auomoto/BOSS-LN2-Controller/README.md

# BOSS-LN2-Controller
## Liquid Nitrogen Fill Controller for the LCO BOSS Spectrograph
This separate unit automatically fills the small CCD dewars on the BOSS Spectrographs from a larger buffer dewar installed on the telescope rotator. That buffer dewar is filled twice a day (dusk, dawn).
