auomoto/BOSS-LN2-Controller/Hardware/Eagle/Thermistor Hysteresis Example.png

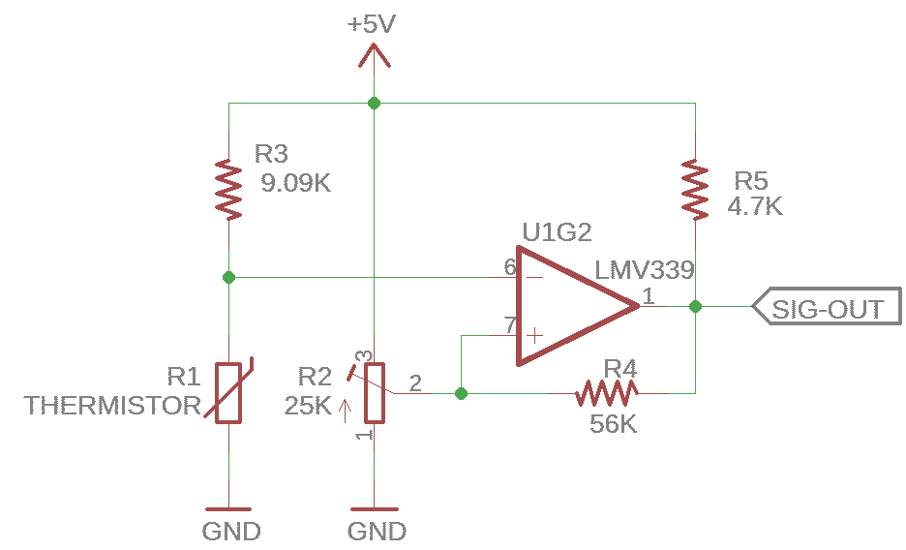
Hardware/Eagle/Thermistor Hysteresis Example.png
