auomoto/BOSS-LN2-Controller/Hardware/Eagle/2021-06-29 LN2 Autofill Controller.pdf

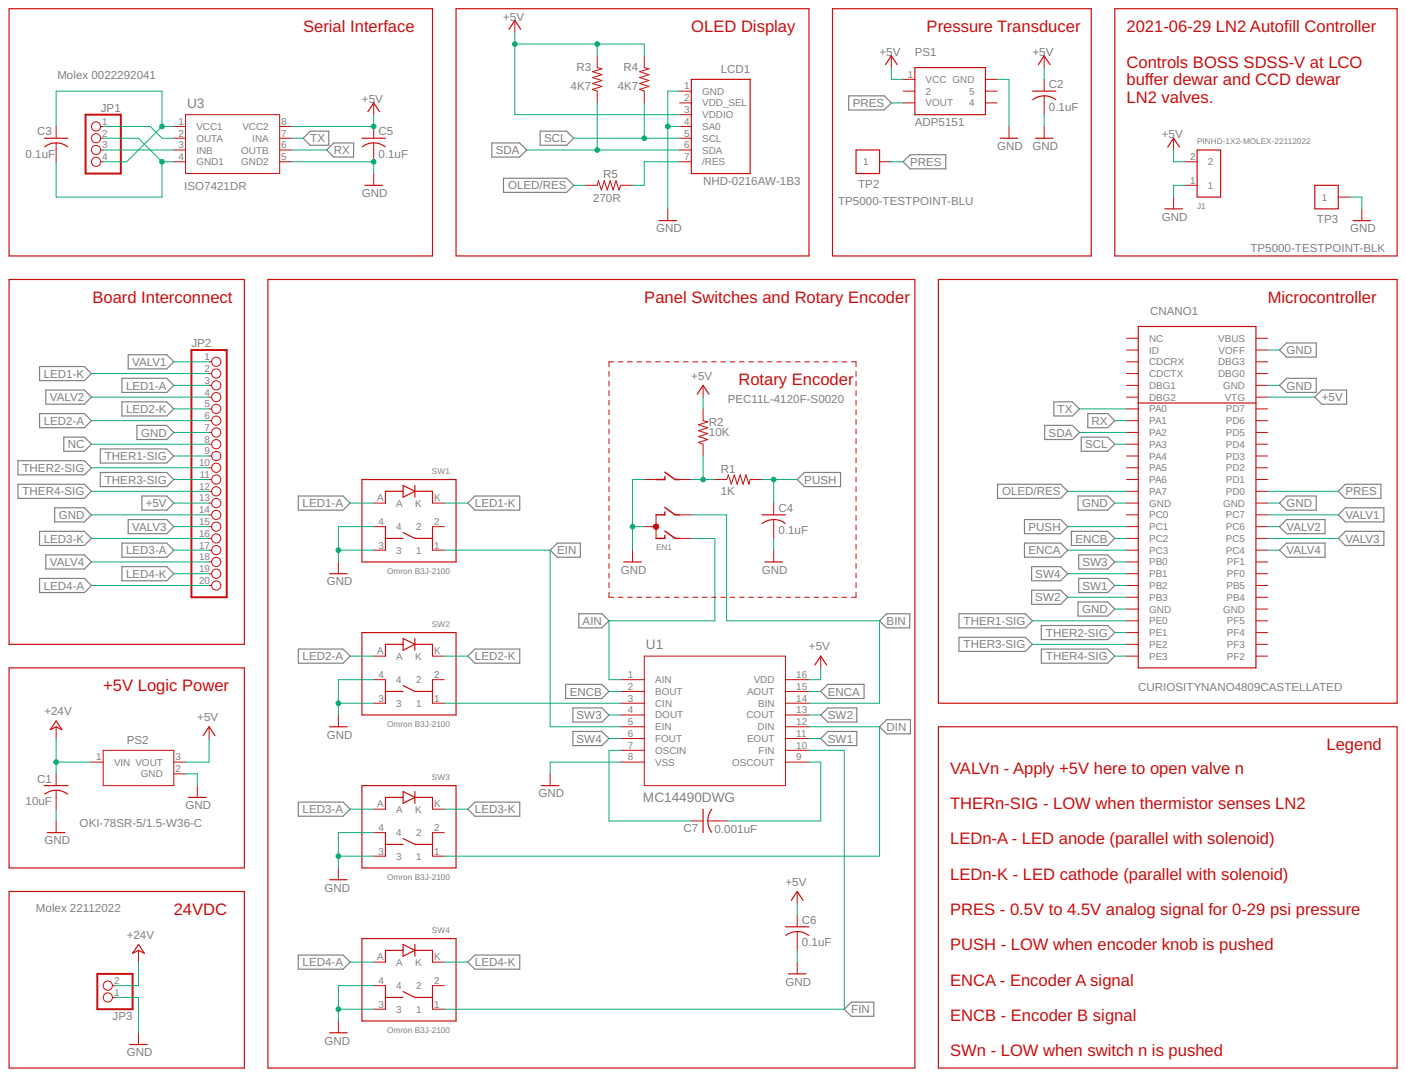
[picture p2: page 1]

Controls BOSS SDSS-V at LCO
buffer dewar and CCD dewar
LN2 valves.

Panel Switches and Rotary Encoder

VALVn - Apply +5V here to open valve n

THERn-SIG - LOW when thermistor senses LN2

LEDn-A - LED anode (parallel with solenoid)

LEDn-K - LED cathode (parallel with solenoid)

PRES - 0.5V to 4.5V analog signal for 0-29 psi pressure

PUSH - LOW when encoder knob is pushed

SWn - LOW when switch n is pushed
