auomoto/BOSS-LN2-Controller/Hardware/Eagle/2023-04-13 LN2 Autofill Connectors.pdf

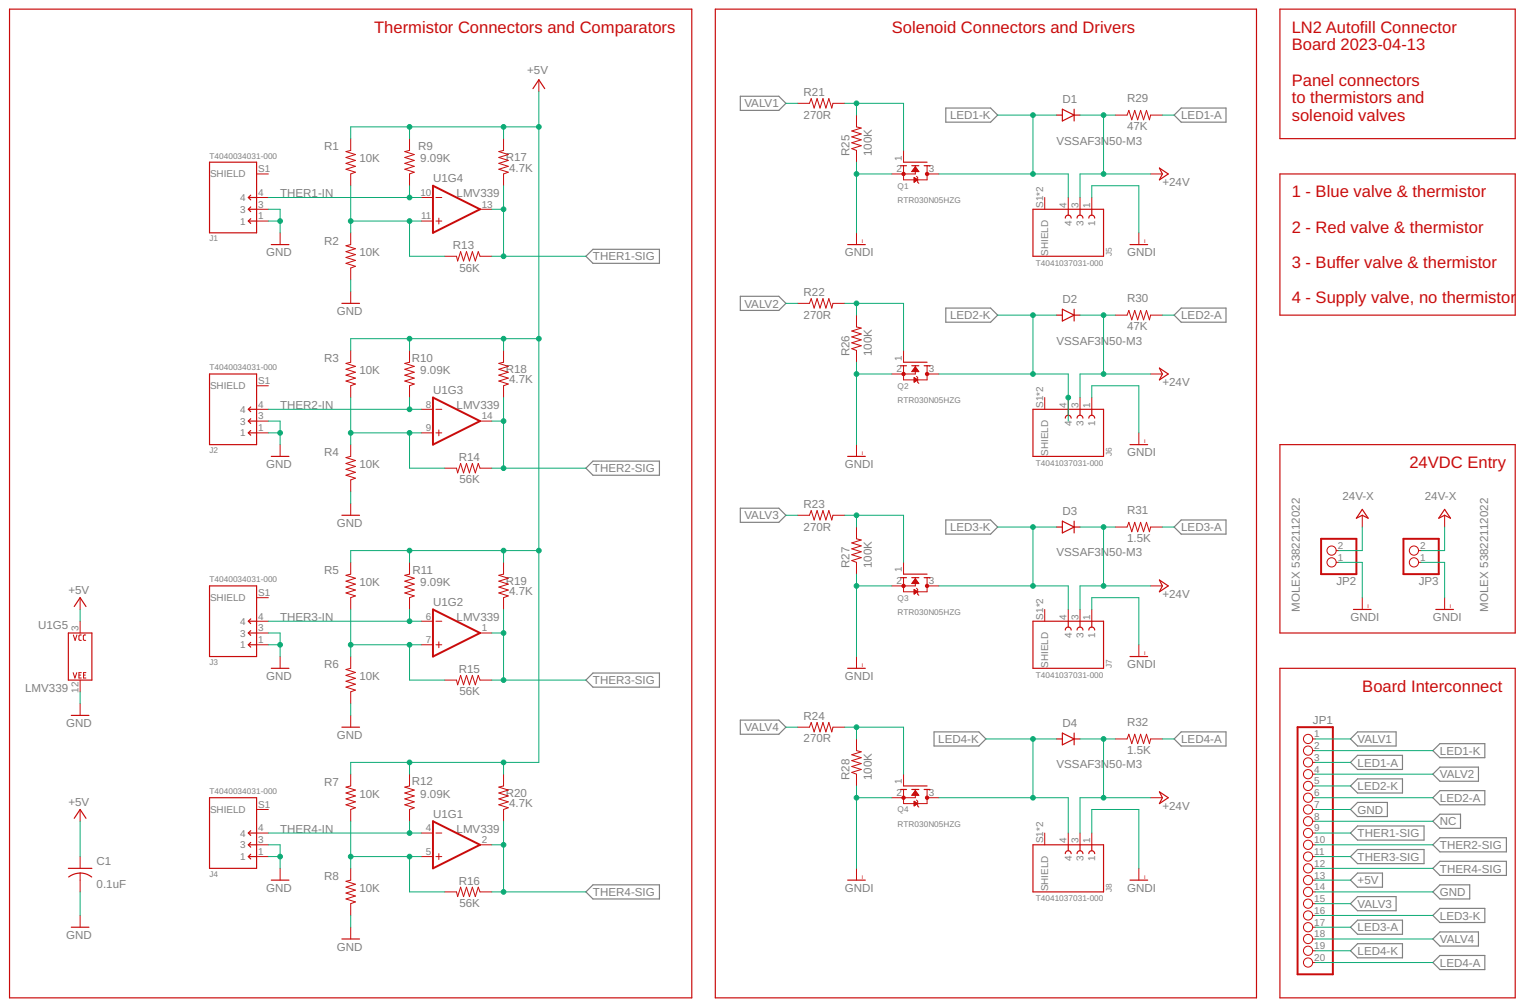
[picture p3: page 1]
