auomoto/BOSS-LN2-Controller/Hardware/Eagle/2020-03-07 LN2 Autofill Connectors - Copy.pdf

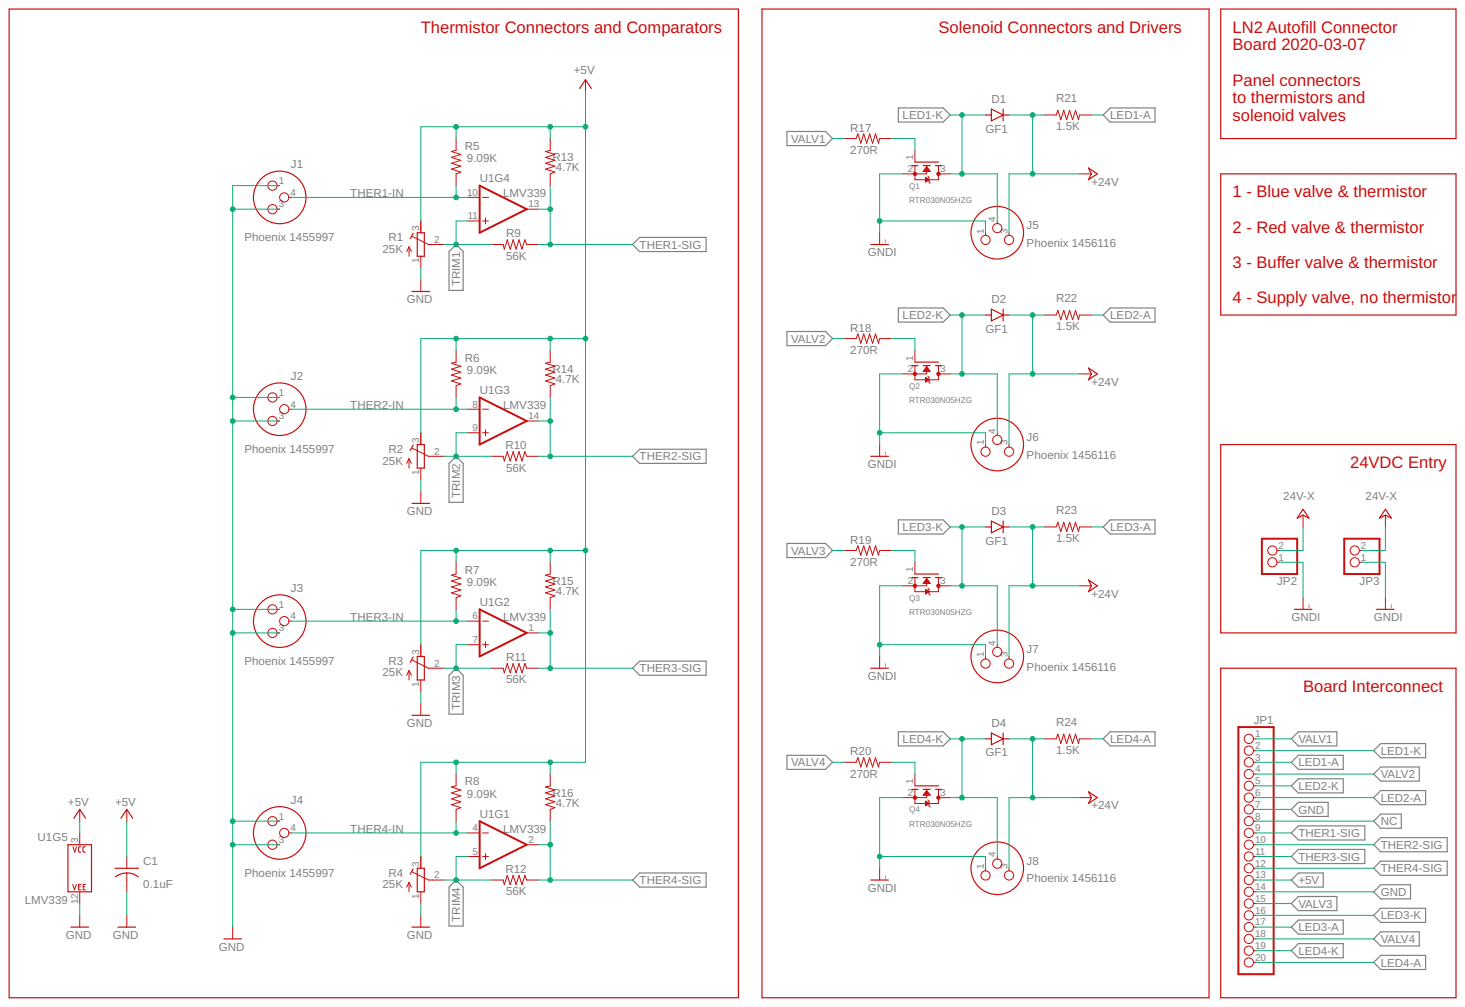
[picture p4: page 1]
