auomoto/BOSS-LN2-Controller/Hardware/Eagle/2022-06-23 LN2 Autofill Controller.brd

## EAGLE design Hardware/Eagle/2022-06-23 LN2 Autofill Controller.brd (2023-01-24)

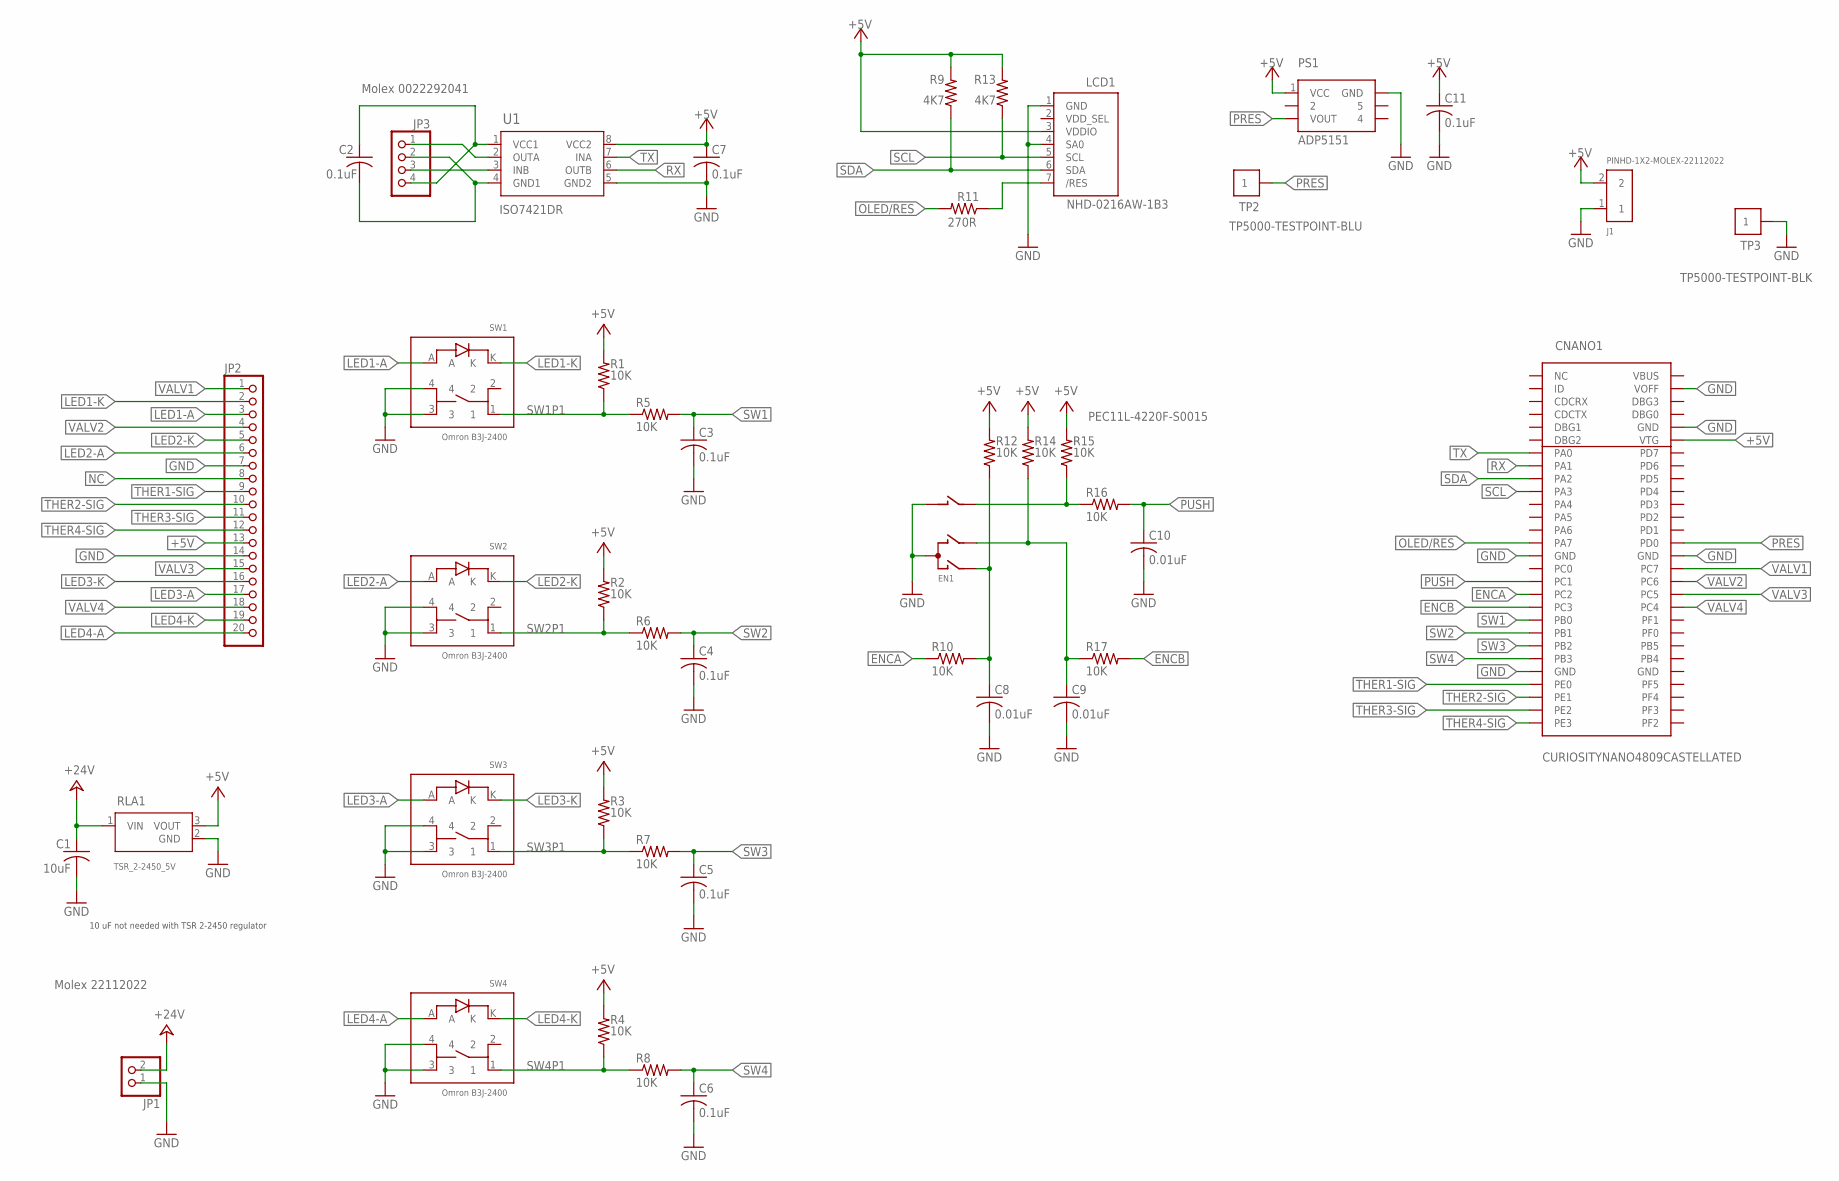
[picture p8: schematic 2022-06-23 LN2 Autofill Controller.sch]

Parts:
C1: 10uF; C1210K
C2, C3, C4, C5, C6, C7, C11: 0.1uF; C0805
C8, C9, C10: 0.01uF; C0805
CNANO1: CURIOSITYNANO4809CASTELLATED
EN1: PEC11L-4220F-S0015; ENC-BOURNES-PEC11L
J1: PINHD-1X2-MOLEX-22112022; 1X02-MOLEX-22112022
JP1: Molex 22112022; MOLEX-02-VERT
JP2: PINHD-1X20; 1X20
JP3: Molex 0022292041; MOLEX-04-VERT
LCD1: NHD-0216AW-1B3; LCD-NEWHAVEN-16X2
PS1: ADP5151; PRESSURE-SENSOR-ADP5151
R1, R2, R3, R4, R5, R6, R7, R8, R10, R12, R14, R15, R16, R17: 10K; R0805
R9, R13: 4K7; R0805
R11: 270R; R0805
RLA1: TSR_2-2450_5V; TSR2-SINGLE_TRP
SW1, SW2, SW3, SW4: Omron B3J-2400; SWITCH-OMRON-B3J-1LED
TP2: TP5000-TESTPOINT-BLU
TP3: TP5000-TESTPOINT-BLK
U1: ISO7421DR; SOIC127P599X175-8N

Connections:
+5V: C7.1, C11.1, CNANO1.VTG, J1.2, JP2.13, LCD1.3 (VDDIO), PS1.1 (VCC), R1.2, R2.2, R3.2, R4.2, R9.2, R12.2, R13.2, R14.2, R15.2, RLA1.3 (VOUT), U1.8 (VCC2)
+24V: C1.1, JP1.2, RLA1.1 (VIN)
/RES: LCD1.7 (/RES), R11.1
ENCA: CNANO1.PC2, R10.1
ENCASW: C8.1, EN1.A, R10.2, R12.1
ENCB: CNANO1.PC3, R17.2
ENCBSW: C9.1, EN1.B, R14.1, R17.1
ENCBUTTON: EN1.1 (B1), R15.1, R16.1
GND: C1.2, C3.2, C4.2, C5.2, C6.2, C7.2, C8.2, C9.2, C10.2, C11.2, CNANO1.GND15 (GND), CNANO1.GND24 (GND), CNANO1.GND42 (GND), CNANO1.GND52 (GND), CNANO1.VOFF, EN1.2 (C1), EN1.C, J1.1, JP1.1, JP2.7, JP2.14, LCD1.1 (GND), LCD1.4 (SA0), PS1.6 (GND), RLA1.2 (GND), SW1.3, SW1.4, SW2.3, SW2.4, SW3.3, SW3.4, SW4.3, SW4.4, TP3.P$1, U1.5 (GND2)
GND1: C2.2, JP3.2, U1.4 (GND1)
INB: JP3.3, U1.3 (INB)
LED1-A: JP2.3, SW1.A
LED1-K: JP2.2, SW1.K
LED2-A: JP2.6, SW2.A
LED2-K: JP2.5, SW2.K
LED3-A: JP2.17, SW3.A
LED3-K: JP2.16, SW3.K
LED4-A: JP2.20, SW4.A
LED4-K: JP2.19, SW4.K
NC: JP2.8
OLED/RES: CNANO1.PA7-SS (PA7), R11.2
OUTA: JP3.1, U1.2 (OUTA)
PRES: CNANO1.PD0-AIN0 (PD0), PS1.3 (VOUT), TP2.P$1
PUSH: C10.1, CNANO1.PC1-RX (PC1), R16.2
RX: CNANO1.PA1-RX (PA1), U1.6 (OUTB)
SCL: CNANO1.PA3-SCL (PA3), LCD1.5 (SCL), R13.1
SDA: CNANO1.PA2-SDA (PA2), LCD1.6 (SDA), R9.1
SW1: C3.1, CNANO1.PB0-TX (PB0), R5.2
SW1P1: R1.1, R5.1, SW1.1
SW2: C4.1, CNANO1.PB1-RX (PB1), R6.2
SW2P1: R2.1, R6.1, SW2.1
SW3: C5.1, CNANO1.PB2, R7.2
SW3P1: R3.1, R7.1, SW3.1
SW4: C6.1, CNANO1.PB3, R8.2
SW4P1: R4.1, R8.1, SW4.1
THER1-SIG: CNANO1.PE0, JP2.9
THER2-SIG: CNANO1.PE1, JP2.10
THER3-SIG: CNANO1.PE2, JP2.11
THER4-SIG: CNANO1.PE3, JP2.12
TX: CNANO1.PA0-TX (PA0), U1.7 (INA)
VALV1: CNANO1.PC7, JP2.1
VALV2: CNANO1.PC6, JP2.4
VALV3: CNANO1.PC5, JP2.15
VALV4: CNANO1.PC4, JP2.18
VCC1: C2.1, JP3.4, U1.1 (VCC1)

Notes on the sheet:
10 uF not needed with TSR 2-2450 regulator

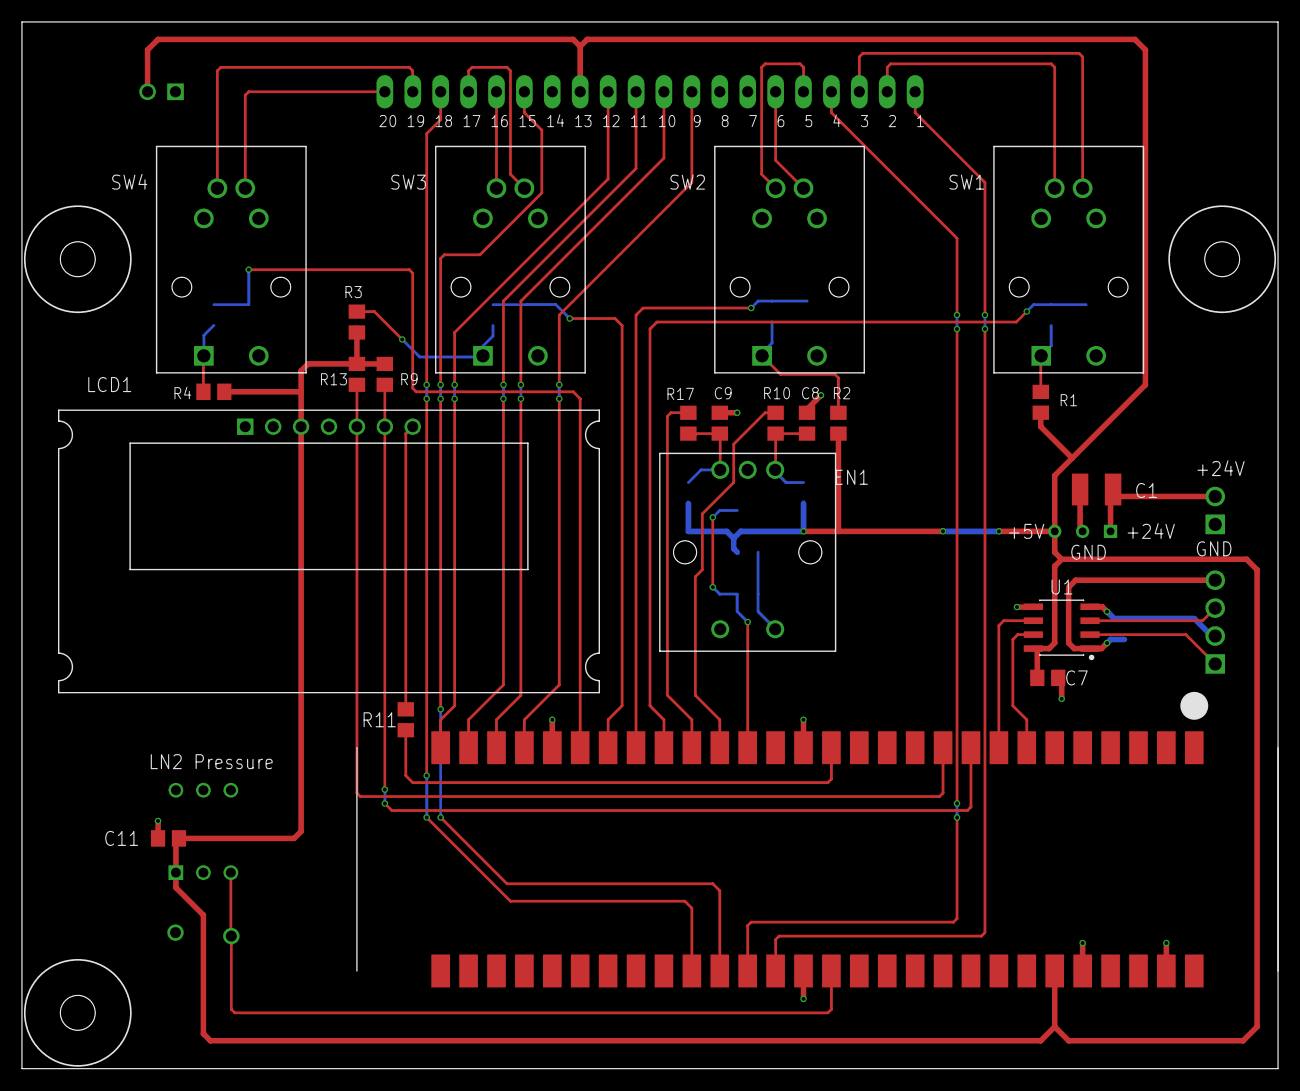
[picture p9: board 2022-06-23 LN2 Autofill Controller.brd from above]

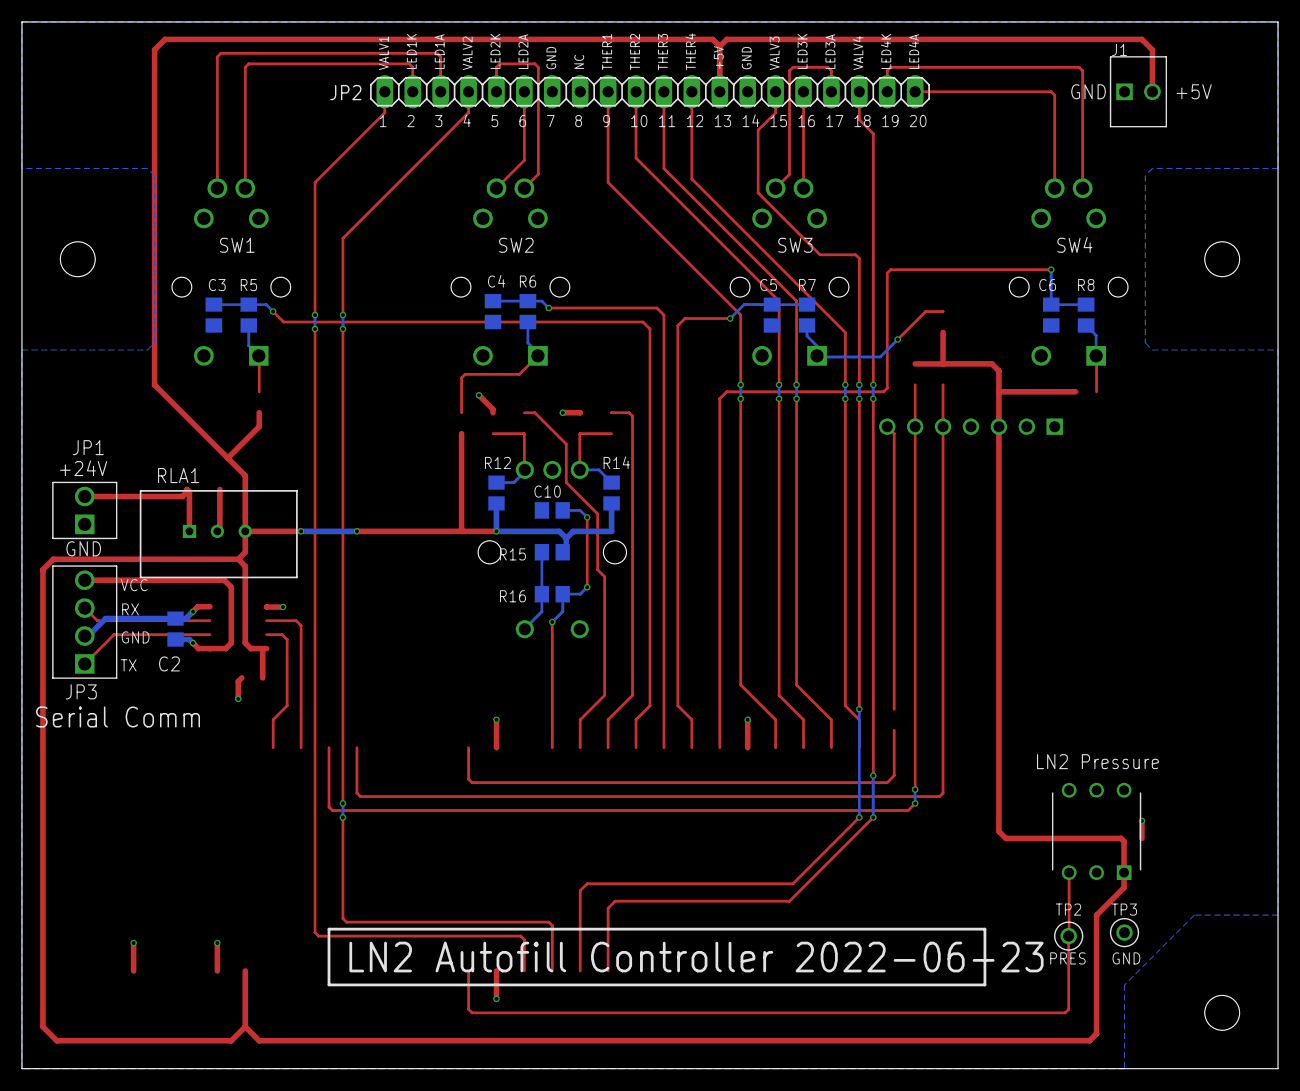
[picture p10: board 2022-06-23 LN2 Autofill Controller.brd from below]

Board: 2 copper layers, 114.3 x 95.2 mm, 44 parts (22 on the bottom side), 44 nets.
