auomoto/BOSS-LN2-Controller/Hardware/Eagle/2020-03-07 LN2 Autofill Connectors - Copy.brd

## EAGLE design Hardware/Eagle/2020-03-07 LN2 Autofill Connectors - Copy.brd (2021-08-19)

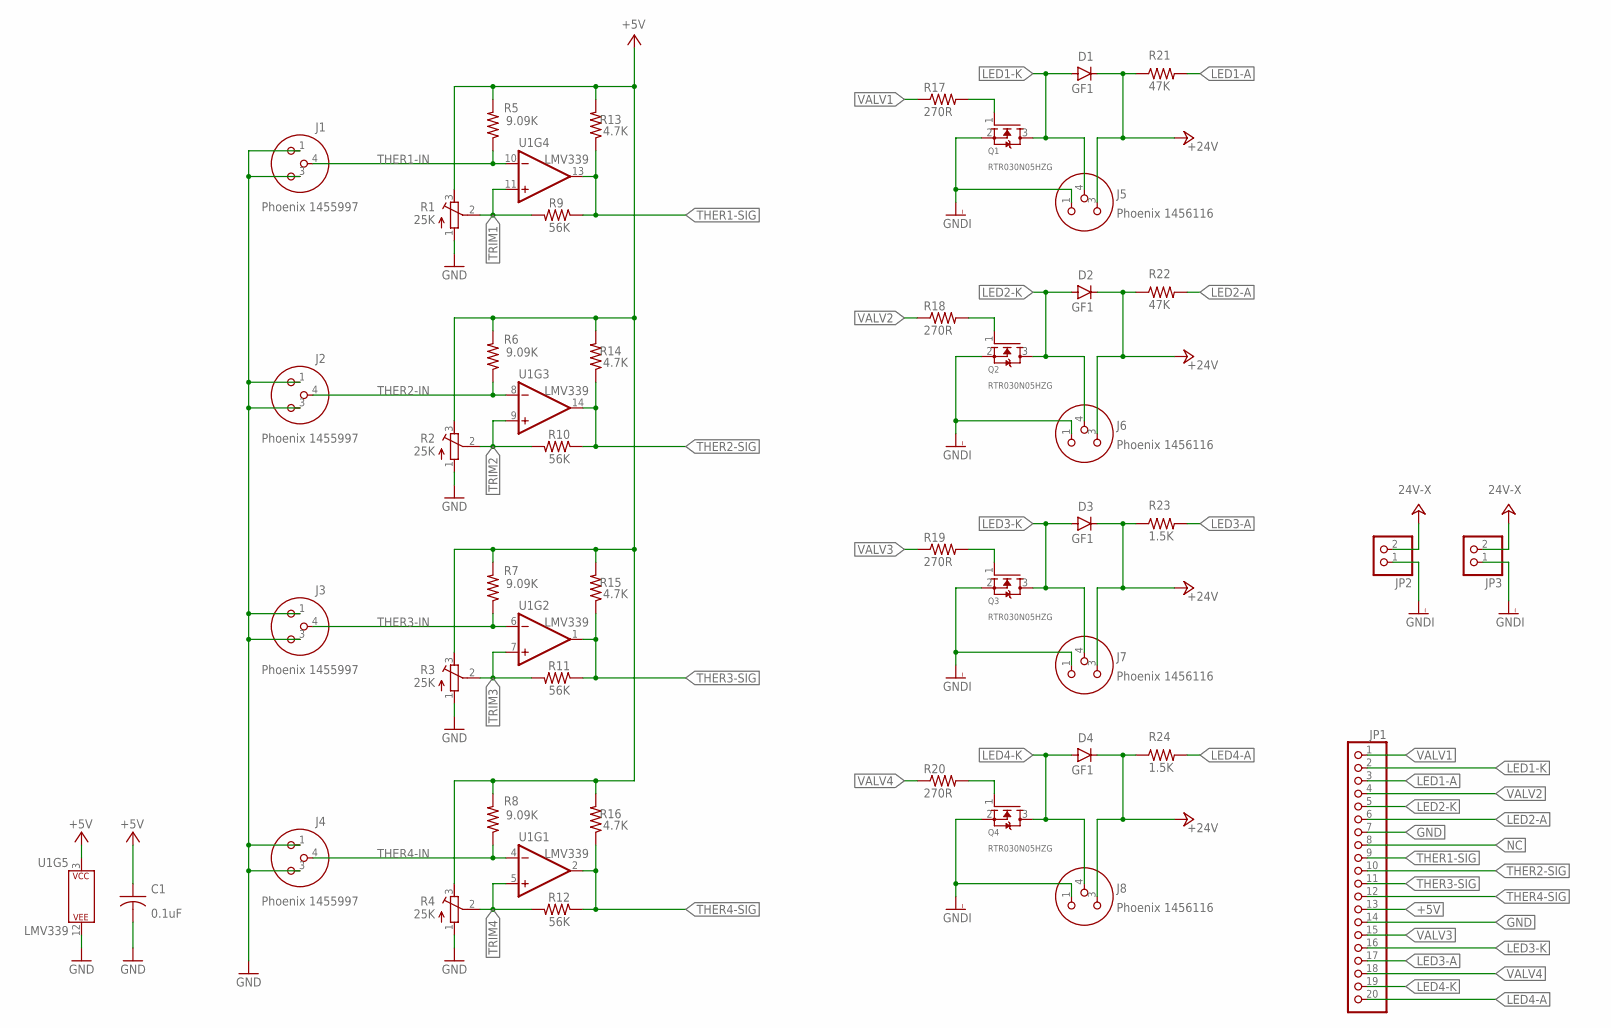
[picture p11: schematic 2020-03-07 LN2 Autofill Connectors - Copy.sch]

Parts:
C1: 0.1uF; C0805
D1, D2, D3, D4: GF1; SMA-DO214AC
J1, J2, J3, J4: Phoenix 1455997; PHOENIX-3PIN
J5, J6, J7, J8: Phoenix 1456116; PHOENIX-3PIN-FEMALE
JP1: PINHD-1X20; 1X20
JP2, JP3: PINHD-1X2MOLEX-02-VERT; MOLEX-02-VERT
Q1, Q2, Q3, Q4: RTR030N05HZG; SOT23
R1, R2, R3, R4: 25K; RTRIM3296Y
R5, R6, R7, R8: 9.09K; R0805
R9, R10, R11, R12: 56K; R0805
R13, R14, R15, R16: 4.7K; R0805
R17, R18, R19, R20: 270R; R0805
R21, R22: 47K; R0805
R23, R24: 1.5K; R0805
U1: LMV339; SOIC127P599X175-14

Connections:
+5V: C1.1, JP1.13, R1.3 (E), R2.3 (E), R3.3 (E), R4.3 (E), R5.2, R6.2, R7.2, R8.2, R13.2, R14.2, R15.2, R16.2, U1.3 (P$V+)
+24V: D1.K (C), D2.K (C), D3.K (C), D4.K (C), J5.3, J6.3, J7.3, J8.3, JP2.2, JP3.2, R21.1, R22.1, R23.1, R24.1
GND: C1.2, J1.1, J1.3, J2.1, J2.3, J3.1, J3.3, J4.1, J4.3, JP1.7, JP1.14, R1.1 (A), R2.1 (A), R3.1 (A), R4.1 (A), U1.12 (P$V-)
GNDI: J5.1, J6.1, J7.1, J8.1, JP2.1, JP3.1, Q1.2 (S), Q2.2 (S), Q3.2 (S), Q4.2 (S)
LED1-A: JP1.3, R21.2
LED1-K: D1.A, J5.4, JP1.2, Q1.3 (D)
LED2-A: JP1.6, R22.2
LED2-K: D2.A, J6.4, JP1.5, Q2.3 (D)
LED3-A: JP1.17, R23.2
LED3-K: D3.A, J7.4, JP1.16, Q3.3 (D)
LED4-A: JP1.20, R24.2
LED4-K: D4.A, J8.4, JP1.19, Q4.3 (D)
unnamed: Q1.1 (G), R17.2
unnamed: Q2.1 (G), R18.2
unnamed: Q3.1 (G), R19.2
unnamed: Q4.1 (G), R20.2
NC: JP1.8
THER1-IN: J1.4, R5.1, U1.10 (-IN)
THER1-SIG: JP1.9, R9.1, R13.1, U1.13 (OUT)
THER2-IN: J2.4, R6.1, U1.8 (-IN)
THER2-SIG: JP1.10, R10.1, R14.1, U1.14 (OUT)
THER3-IN: J3.4, R7.1, U1.6 (-IN)
THER3-SIG: JP1.11, R11.1, R15.1, U1.1 (OUT)
THER4-IN: J4.4, R8.1, U1.4 (-IN)
THER4-SIG: JP1.12, R12.1, R16.1, U1.2 (OUT)
TRIM1: R1.2 (S), R9.2, U1.11 (+IN)
TRIM2: R2.2 (S), R10.2, U1.9 (+IN)
TRIM3: R3.2 (S), R11.2, U1.7 (+IN)
TRIM4: R4.2 (S), R12.2, U1.5 (+IN)
VALV1: JP1.1, R17.1
VALV2: JP1.4, R18.1
VALV3: JP1.15, R19.1
VALV4: JP1.18, R20.1

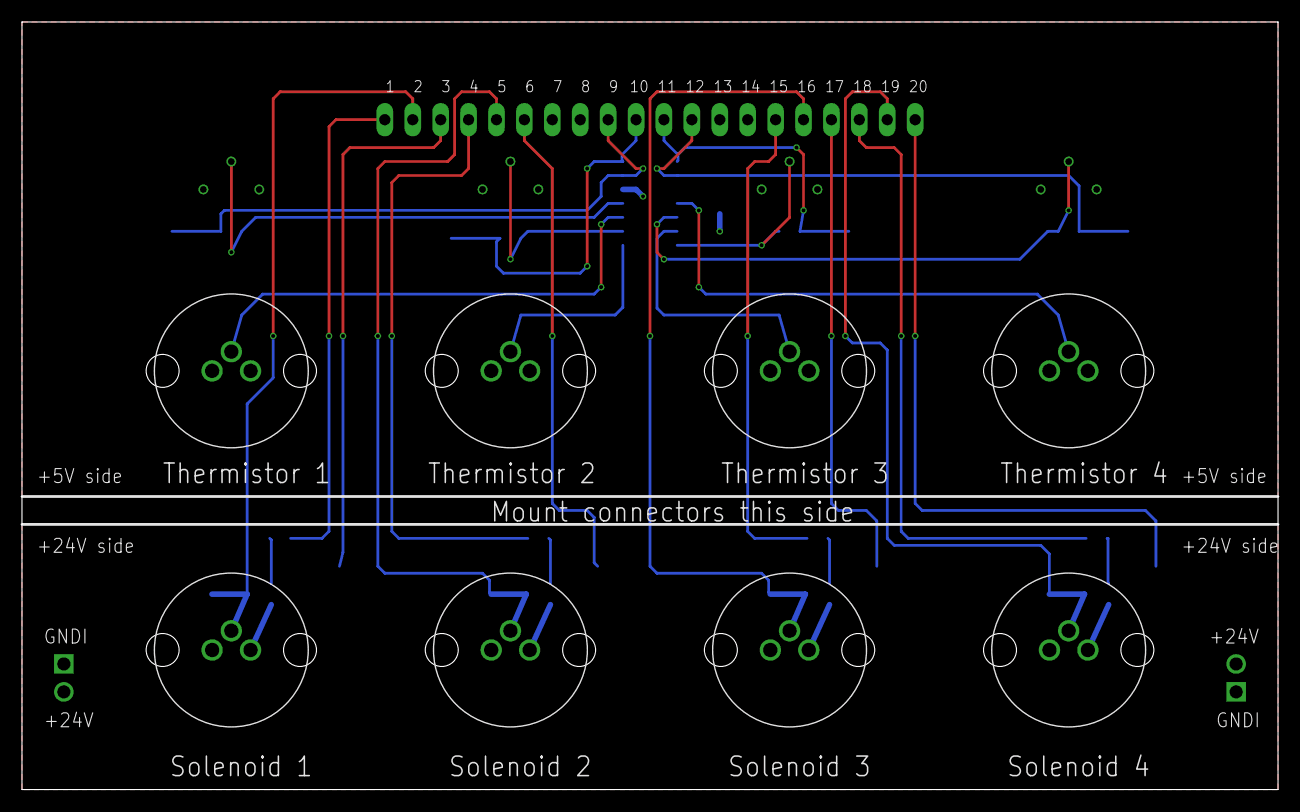
[picture p12: board 2020-03-07 LN2 Autofill Connectors - Copy.brd from above]

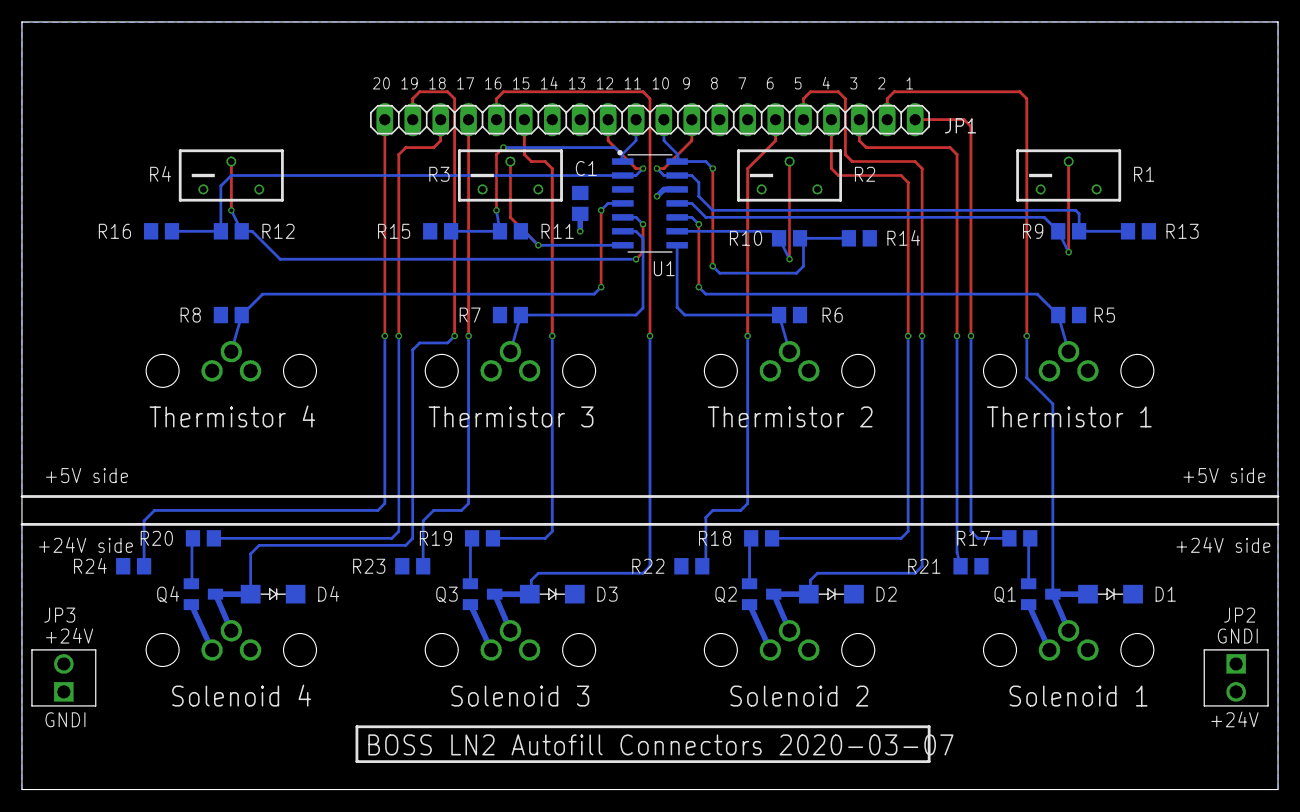
[picture p13: board 2020-03-07 LN2 Autofill Connectors - Copy.brd from below]

Board: 2 copper layers, 114.3 x 69.8 mm, 45 parts (37 on the bottom side), 32 nets.
