auomoto/BOSS-LN2-Controller/Hardware/Eagle/2021-06-29 LN2 Autofill Controller.brd

## EAGLE design Hardware/Eagle/2021-06-29 LN2 Autofill Controller.brd (2021-07-24)

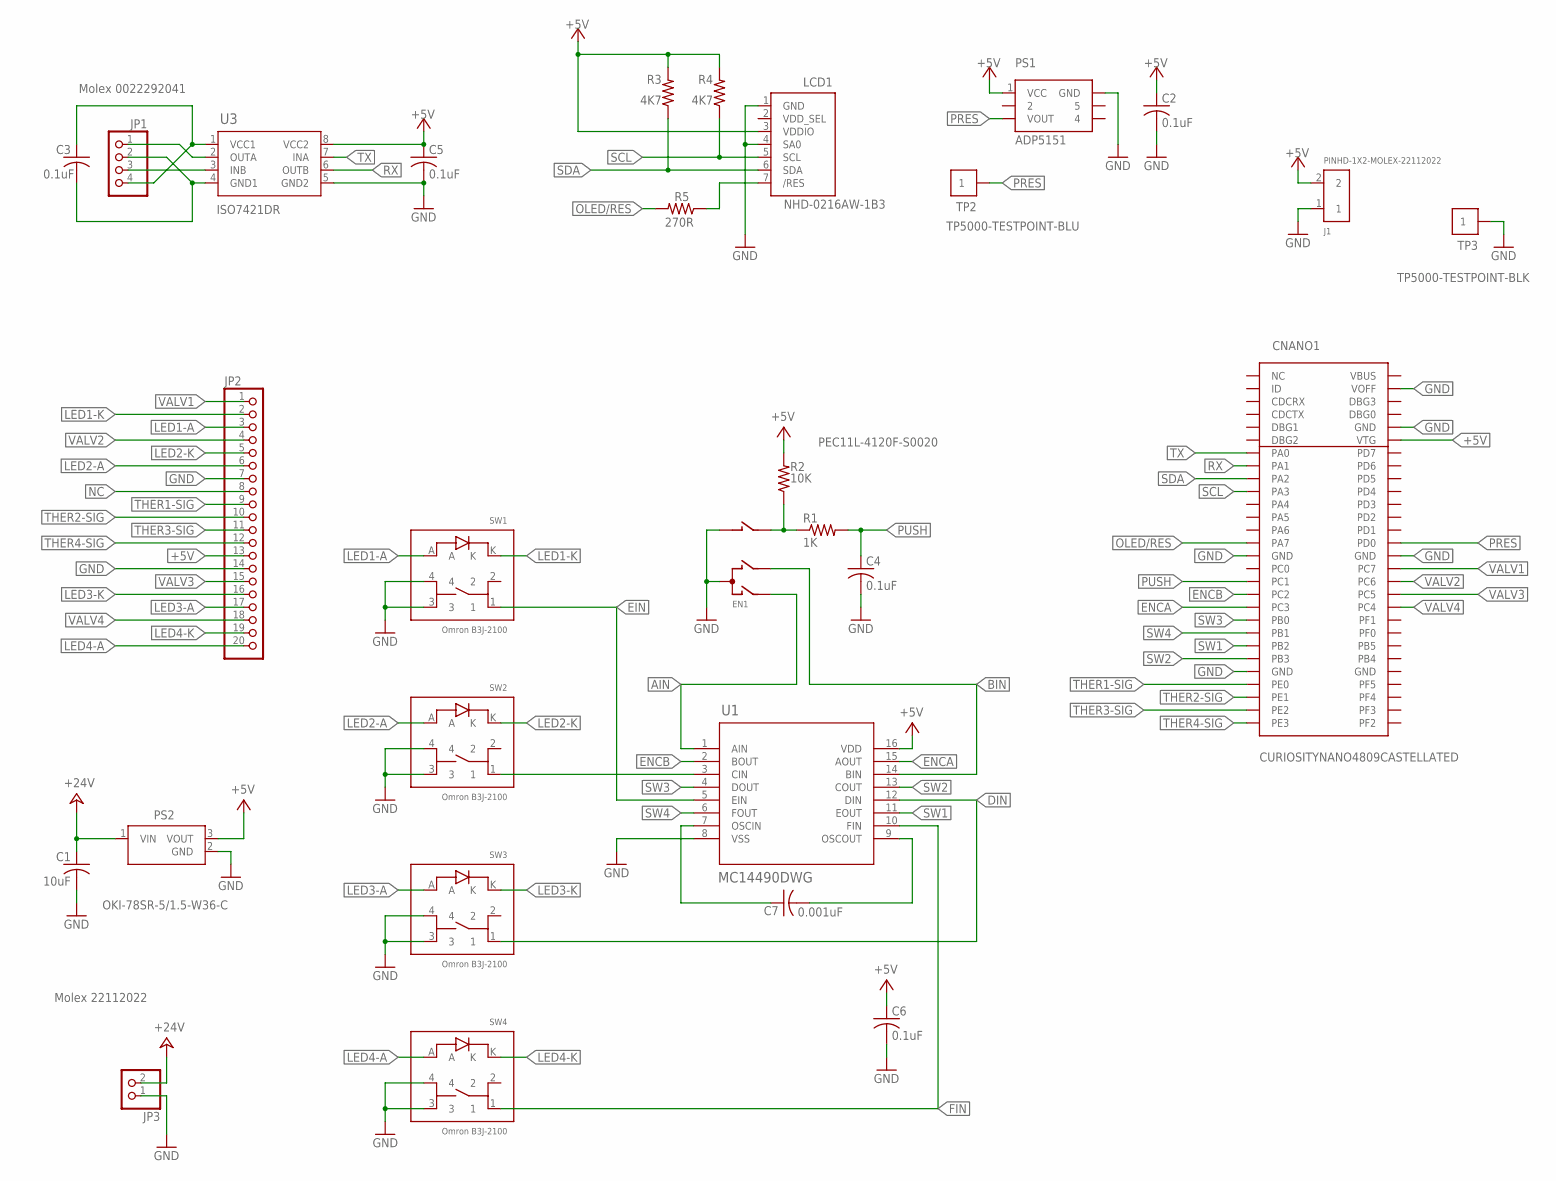
[picture p14: schematic 2021-06-29 LN2 Autofill Controller.sch]

Parts:
C1: 10uF; C1210K
C2, C3, C4, C5, C6: 0.1uF; C0805
C7: 0.001uF; C0805
CNANO1: CURIOSITYNANO4809CASTELLATED
EN1: PEC11L-4120F-S0020; ENC-BOURNES-PEC11L
J1: PINHD-1X2-MOLEX-22112022; 1X02-MOLEX-22112022
JP1: Molex 0022292041; MOLEX-04-VERT
JP2: PINHD-1X20; 1X20
JP3: Molex 22112022; MOLEX-02-VERT
LCD1: NHD-0216AW-1B3; LCD-NEWHAVEN-16X2
PS1: ADP5151; PRESSURE-SENSOR-ADP5151
PS2: OKI-78SR-5/1.5-W36-C; CONV_OKI-78SR-5/1.5-W36-C
R1: 1K; R0805
R2: 10K; R0805
R3, R4: 4K7; R0805
R5: 270R; R0805
SW1, SW2, SW3, SW4: Omron B3J-2100; SWITCH-OMRON-B3J-1LED
TP2: TP5000-TESTPOINT-BLU
TP3: TP5000-TESTPOINT-BLK
U1: MC14490DWG; SOIC127P1030X265-16N
U3: ISO7421DR; SOIC127P599X175-8N

Connections:
+5V: C2.1, C5.1, C6.1, CNANO1.VTG, J1.2, JP2.13, LCD1.3 (VDDIO), PS1.1 (VCC), PS2.3 (VOUT), R2.2, R3.2, R4.2, U1.16 (VDD), U3.8 (VCC2)
+24V: C1.1, JP3.2, PS2.1 (VIN)
/RES: LCD1.7 (/RES), R5.1
AIN: EN1.A, U1.1 (AIN)
BIN: EN1.B, U1.14 (BIN)
CIN: SW2.1, U1.3 (CIN)
DIN: SW3.1, U1.12 (DIN)
EIN: SW1.1, U1.5 (EIN)
ENCA: CNANO1.PC3, U1.15 (AOUT)
ENCB: CNANO1.PC2, U1.2 (BOUT)
ENCBUTTON: EN1.1 (B1), R1.1, R2.1
FIN: SW4.1, U1.10 (FIN)
GND: C1.2, C2.2, C4.2, C5.2, C6.2, CNANO1.GND15 (GND), CNANO1.GND24 (GND), CNANO1.GND42 (GND), CNANO1.GND52 (GND), CNANO1.VOFF, EN1.2 (C1), EN1.C, J1.1, JP2.7, JP2.14, JP3.1, LCD1.1 (GND), LCD1.4 (SA0), PS1.6 (GND), PS2.2 (GND), SW1.3, SW1.4, SW2.3, SW2.4, SW3.3, SW3.4, SW4.3, SW4.4, TP3.P$1, U1.8 (VSS), U3.5 (GND2)
GND1: C3.2, JP1.2, U3.4 (GND1)
INB: JP1.3, U3.3 (INB)
LED1-A: JP2.3, SW1.A
LED1-K: JP2.2, SW1.K
LED2-A: JP2.6, SW2.A
LED2-K: JP2.5, SW2.K
LED3-A: JP2.17, SW3.A
LED3-K: JP2.16, SW3.K
LED4-A: JP2.20, SW4.A
LED4-K: JP2.19, SW4.K
NC: JP2.8
OLED/RES: CNANO1.PA7-SS (PA7), R5.2
OSCIN: C7.1, U1.7 (OSCIN)
OSCOUT: C7.2, U1.9 (OSCOUT)
OUTA: JP1.1, U3.2 (OUTA)
PRES: CNANO1.PD0-AIN0 (PD0), PS1.3 (VOUT), TP2.P$1
PUSH: C4.1, CNANO1.PC1-RX (PC1), R1.2
RX: CNANO1.PA1-RX (PA1), U3.6 (OUTB)
SCL: CNANO1.PA3-SCL (PA3), LCD1.5 (SCL), R4.1
SDA: CNANO1.PA2-SDA (PA2), LCD1.6 (SDA), R3.1
SW1: CNANO1.PB2, U1.11 (EOUT)
SW2: CNANO1.PB3, U1.13 (COUT)
SW3: CNANO1.PB0-TX (PB0), U1.4 (DOUT)
SW4: CNANO1.PB1-RX (PB1), U1.6 (FOUT)
THER1-SIG: CNANO1.PE0, JP2.9
THER2-SIG: CNANO1.PE1, JP2.10
THER3-SIG: CNANO1.PE2, JP2.11
THER4-SIG: CNANO1.PE3, JP2.12
TX: CNANO1.PA0-TX (PA0), U3.7 (INA)
VALV1: CNANO1.PC7, JP2.1
VALV2: CNANO1.PC6, JP2.4
VALV3: CNANO1.PC5, JP2.15
VALV4: CNANO1.PC4, JP2.18
VCC1: C3.1, JP1.4, U3.1 (VCC1)

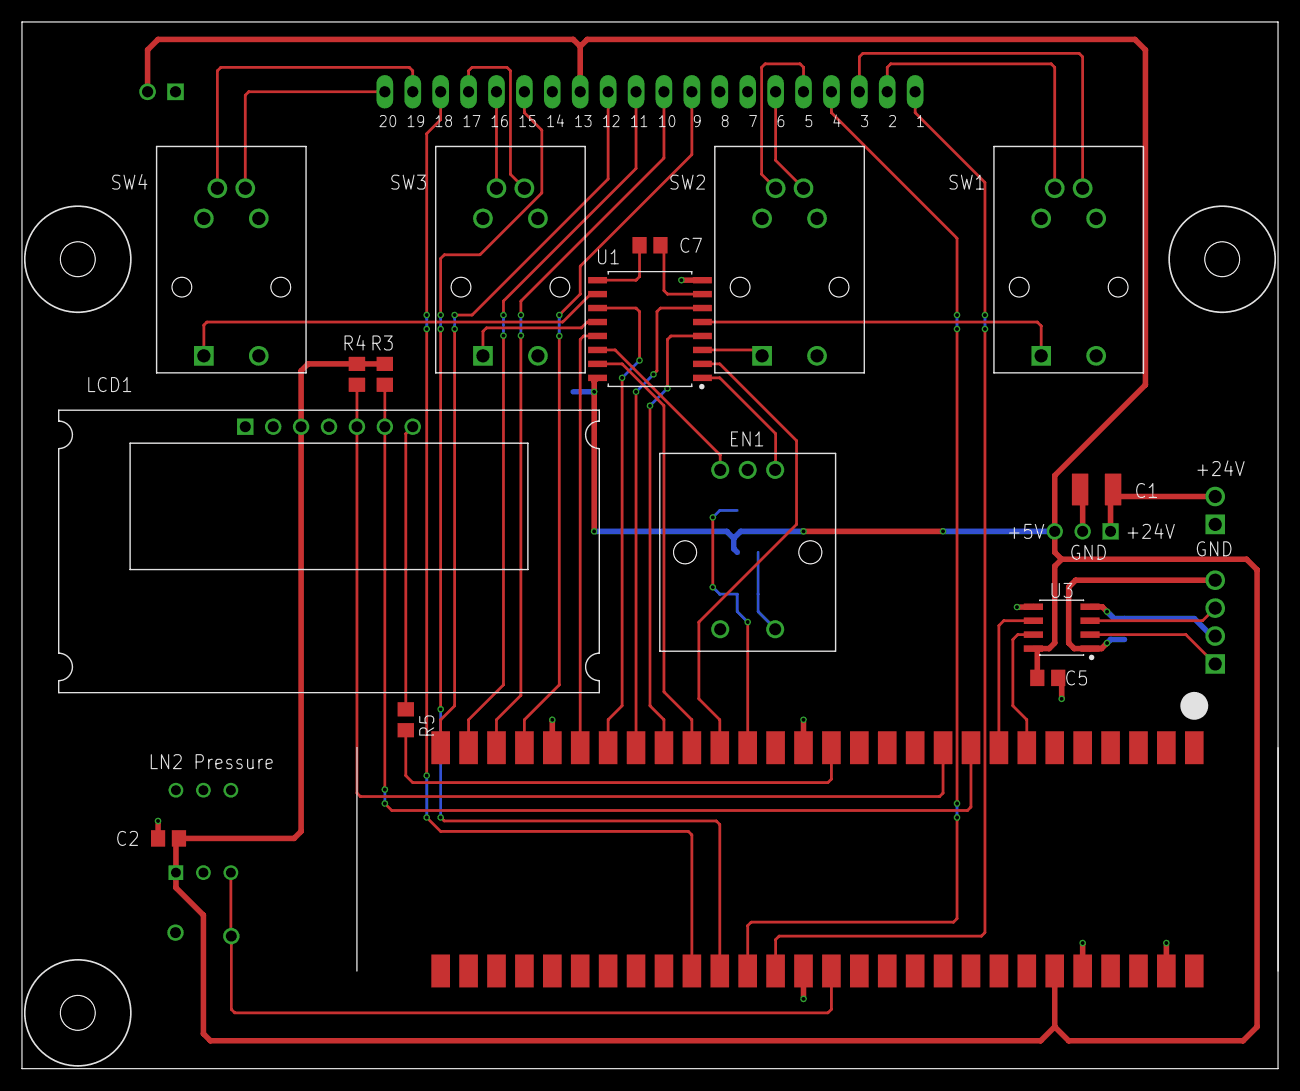
[picture p15: board 2021-06-29 LN2 Autofill Controller.brd from above]

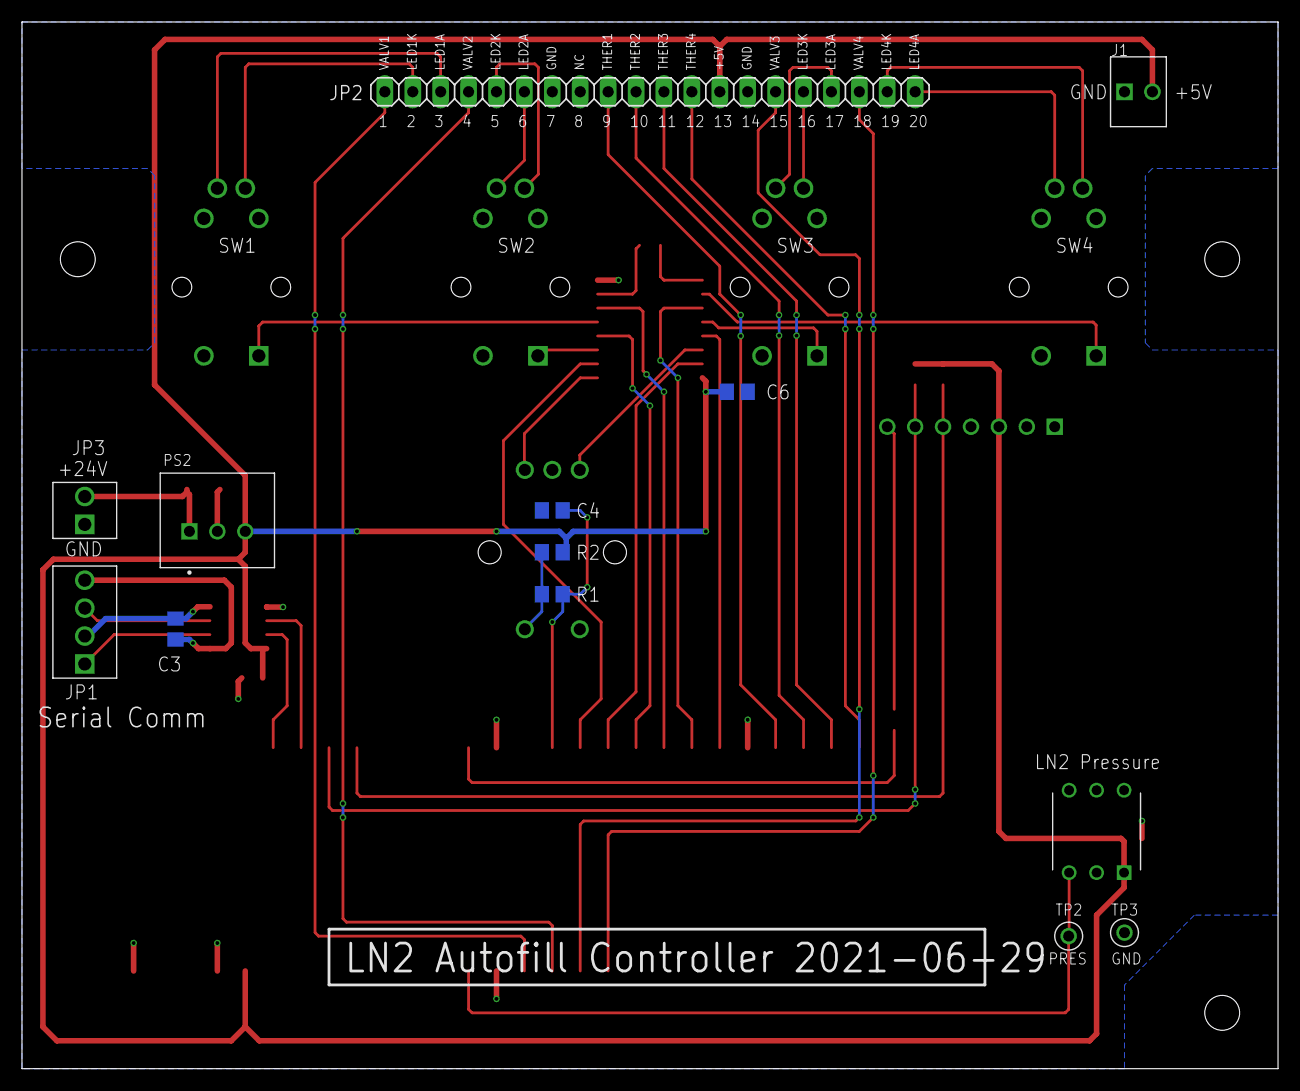
[picture p16: board 2021-06-29 LN2 Autofill Controller.brd from below]

Board: 2 copper layers, 114.3 x 95.2 mm, 29 parts (13 on the bottom side), 46 nets.
