auomoto/BOSS-LN2-Controller/Software/Atmel Studio/LN2 Autofill No Debouncer/LN2 Autofill No Debouncer/init.h

#ifndef INIT_H
#define INIT_H

#include "buttons.h"
#include "eeprom.h"
#include "oled.h"
#include "rtc.h"
#include "twi.h"
#include "buttons.h"
#include "encoder.h"
#include "pressure.h"
#include "usart.h"

void init(void);

#endif
