auomoto/BOSS-LN2-Controller/Software/Atmel Studio/LN2 Autofill No Debouncer/LN2 Autofill No Debouncer/twi.h

#ifndef TWI_H
#define TWI_H

#include "globals.h"
#include "timers.h"

#define TWIFREQ		100000UL		// Fastest allowed for F_CPU = 3.33 MHz
#define TWIBAUD		((uint8_t) (F_CPU/(2*TWIFREQ)) - 5)	// Ignore rise time
#define TWIWRITE	0
#define TWIREAD		1
#define TWIARBLOST	2
#define TWIBUSERROR	3
#define TWITIMEOUT	4
#define TWINODEVICE	5
#define TWINOACK	6

void init_TWI(void);
uint8_t read_TWI(void);
uint8_t readlast_TWI(void);
uint8_t start_TWI(uint8_t, uint8_t);
void stop_TWI(void);
uint8_t write_TWI(uint8_t);

#endif
