auomoto/BOSS-LN2-Controller/(commit log)

2020-10-28 Initial Load
    Transferred from old GIT directory
    [2020-03-07 LN2 Autofill Connectors - Copy.brd, 2020-03-07 LN2 Autofill Connectors - Copy.sch, 2020-03-08 LN2 Autofill Controller.brd, 2020-03-08 LN2 Autofill Controller.sch, Thermistor Hysteresis Example.sch]
2020-11-28 Added 6-pin RJ11 breakout board
    The 4-pin versions are less common and out of stock at Digikey (2020-11-28) while the 6-pin versions are OK
    [2020-03-08 LN2 Autofill Controller.sch, RJ11-6-PIN Breakout.brd, RJ11-6-PIN Breakout.sch]
2020-11-29 Switched to a right angle connector on the RJ11 breakout
    [2020-03-08 LN2 Autofill Controller.sch, RJ11-6-PIN Breakout.brd]
2020-11-30 Swapped 5VDC convert to stand-up version
    [2020-03-08 LN2 Autofill Controller.brd, 2020-03-08 LN2 Autofill Controller.sch]
2020-11-30 Removed top & bottom copper pours
    [2020-03-08 LN2 Autofill Controller.brd]
2020-11-30 Removed bottom polygon (missed some before)
    [2020-03-08 LN2 Autofill Controller.brd]
2020-11-30 Start rewiring
    [2020-03-08 LN2 Autofill Controller.brd, 2020-03-08 LN2 Autofill Controller.sch]
2020-11-30 Rerouted controller board, putting most traces on the top
    [2020-03-08 LN2 Autofill Controller.brd]
2021-01-05 Save minor changes?
    [2020-03-08 LN2 Autofill Controller.brd, 2020-03-08 LN2 Autofill Controller.sch]
2021-02-10 Examined RJ11 connectors (no changes)
    [RJ11-6-PIN Breakout.brd]
2021-02-19 Re-pinned the serial connector, changed track widths
    [LN2 Autofill Controller.brd, LN2 Autofill Controller.sch, RJ11-6-PIN Breakout.brd, RJ11-6-PIN Breakout.sch]
2021-02-20 Made copies of the RJ11 breakout and ? on LN2 board
    [2021-02-20 RJ11-6-PIN Breakout Ordered.brd, 2021-02-20 RJ11-6-PIN Breakout Ordered.sch, LN2 Autofill Connectors.brd, LN2 Autofill Connectors.sch]
2021-02-22 Added gate resistor and re-routed connector board
    [LN2 Autofill Connectors.brd, LN2 Autofill Connectors.sch]
2021-07-24 FInal check before ordering
    [2021-06-29 LN2 Autofill Controller.brd, 2021-06-29 LN2 Autofill Controller.sch]
2021-08-19 Brought in test code developed in a different directory
    [2020-03-07 LN2 Autofill Connectors - Copy.brd, 2020-03-07 LN2 Autofill Connectors - Copy.sch, LN2 Autofill Connectors.brd, LN2 Autofill Connectors.sch, RJ11-4-PIN to Header.brd, RJ11-4-PIN to Header.sch]
2021-08-26 Revised for new LN2 controller board
2021-09-12 Fast update on pressure display (not tested)
2021-09-13 Pressure pressure display update
    Turn off the pressure display if the number hasn't changed
2021-11-10 Fixed power-on sup valve open problem
    [buttons.c, buttons.h, globals.h, init.c, pressure.c, rtc.c]
2022-03-04 Added supply button safety feature
2022-05-27 Reformatted serial report, removed 2s cable msg
2022-06-14 Added TCB2 oscillator signal for debouncer
    Need to put in a wire from PC0 to the right-hand pad near the debouncer
    [buttons.c, globals.h, init.c, rtc.c, timers.c, timers.h, valves.h]
2022-07-15 Created no-debouncer version
    [2022-06-23 LN2 Autofill Controller.brd, 2022-06-23 LN2 Autofill Controller.sch]
2022-07-17 Worked out bugs on no-debouncer version
    [buttons.c, buttons.h, encoder.c, encoder.h, globals.h, main.c, rtc.c]
2023-09-14 LN2 autofill update
    [2023-04-01 LN2 Autofill Connectors - Copy.sch, 2023-04-01 LN2 Autofill Controller - Copy.brd, 2023-04-06 Thermistor Hysteresis Example.sch, 2023-04-13 LN2 Autofill Connectors.brd, 2023-04-13 LN2 Autofill Connectors.sch, LN2 Autofill Connectors.brd]
