auomoto/BOSS-LN2-Controller/(notices)

Notices in the files:
parts and their libraries:
AUmlib: COPYRIGHT: Copyright (C) 2022 Ultra Librarian. All rights reserved.
AUmlib: COPYRIGHT: Copyright (C) 2016 Accelerated Designs. All rights reserved
